DemianMArin/NYCMOS/docs/images/nycmos_block_diag_v3.png

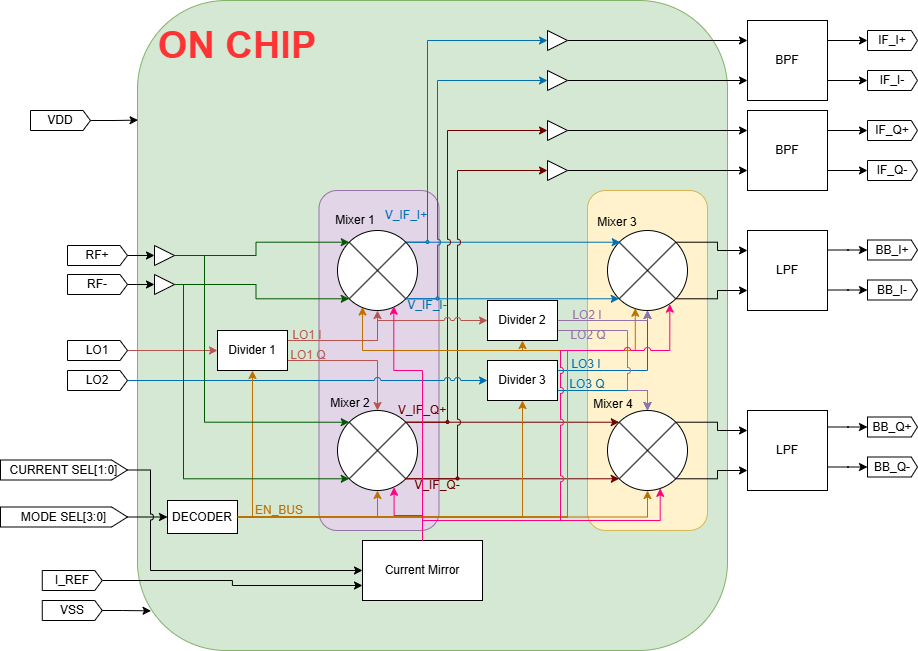
docs/images/nycmos_block_diag_v3.png
