DemianMArin/NYCMOS/(commit log)

2026-06-18 Initial Divider Design and TB
    added initial divider design, symbol, and test bench
    [divider.sch, tb_divider.sch]
2026-06-18 implemented fft plot
    fixed naming issue, and added plot of differential LO output spectrum
    [tb_divider.sch]
2026-06-21 Initial Decoder
    Initial Decoder, truth table, and testbench
    [decoder.sch, tb_decoder.sch]
2026-06-22 initial mixer sizing and design
    [mixer.sch, mixer_tb.sch, tb_divider.sch]
2026-06-23 Divider with MIM caps and poly resistors
    Reduced Output stage input resistor from 25k to 8k.
    Replaced Flipflop resistors with P poly resistors with ~2kohm value.
    Replaced output amplifier resistors with P poly resistors with ~8kohm value.
    Replaced output decoupling capacitors with MIM analog capacitors with ~1 pF value.
    Using MIM_analog caps and 1k sheet resistance P poly resistors.
    GF180mcuD resistor specs here: https://gf180mcu-pdk.readthedocs.io/en/latest/analog/model_parameters/LV/LV_1_4_4.html
    caps: https://gf180mcu-pdk.readthedocs.io/en/latest/analog/model_parameters/LV/LV_1_4_6.html
    [divider_ideal_passives.sch, tb_divider.sch]
2026-06-25 Ignore Jupyter artifacts
    [mixer_tb.sch]
2026-06-29 Complete mixer and enable
    [mixer.sch, mixer_tb.sch]
2026-06-29 Revert unintended divider tb
    [tb_divider.sch]
2026-06-30 Divider PVT and phase delay measurement
    Added PVT options for tt, ff, ss, sf, fs at 27C. Added phase error measurement and first harmonic magnitude mismatch measurement to simulation code.
    [divider.sch, tb_divider.sch, tb_divider_pvt.sch]
2026-06-30 Updated xschemrc
    Updated xschemrc so that it adds /foss/designs/NYCMOS to the search path to avoid bricking previous simulations
    [tb_decoder.sch]
2026-07-02 Add current mirrors and testbenches
    [mirror_network.sch, mirror_network_tb.sch, mixer.sch, mixer_with_mirror_tb.sch, nmos_mirror.sch, pmos_mirror.sch, pmos_mirror_tb.sch]
2026-07-03 Add current control pins for mirrors
    [inv.sch, mirror_network_tb.sch, mirror_network_with_enable.sch, mirror_network_with_enable_tb.sch, mixer.sch, mixer_with_mirror_en_tb.sch, mixer_with_mirror_tb.sch, nmos_mirror.sch]
2026-07-03 Current control logic and testbench
    [decoder.sch, decoder_tb.sch, inv.sch, mixer_with_mirror_en_tb.sch, nand.sch, nmos_mirror_with_enable.sch, nor.sch, transmission_gate.sch]
2026-07-03 Mixer tb with full logic
    [mixer_with_mirror_en_tb.sch]
2026-07-04 Updated block diagram
    Added current select pins and current mirror to block diagram
2026-07-04 updated block diagram
    added i_ref pin to block diagram
2026-07-13 Updated mixer with no gain control
    [mixer_and_divider.sch]
2026-07-15 IIP3 and P1db characterization
    [mixer.sch, mixer_iip3_tb.sch, mixer_p1db.sch]
